Kleven2k/ramsey/rtl/ramsey_pkg.sv

package ramsey_pkg;

    // ---- Clock ---------------------------------------------
    localparam int CLK_FREQ_HZ = 100_000_000;  // Nexys Video Artix-7, 100 MHz

    // ---- UART ----------------------------------------------
    localparam int UART_BAUD   = 115_200;

endpackage
