Kleven2k/ramsey/python/gui.py

import ctypes
import dearpygui.dearpygui as dpg
import uart_comm
import lorentzian_fit
import synthetic

def main():
    dpg.create_context()
    dpg.create_viewport(title="Ramsey", width=1000, height=720)

    # ── Font ──────────────────────────────────────────────────────────────────
    with dpg.font_registry():
        default_font = dpg.add_font("C:/Windows/Fonts/segoeui.ttf", 16)

    # ── Global theme ──────────────────────────────────────────────────────────
    with dpg.theme(tag="global_theme"):
        with dpg.theme_component(dpg.mvAll):
            dpg.add_theme_style(dpg.mvStyleVar_WindowPadding,    10, 10)
            dpg.add_theme_style(dpg.mvStyleVar_FramePadding,      6,  4)
            dpg.add_theme_style(dpg.mvStyleVar_ItemSpacing,        8,  6)
            dpg.add_theme_style(dpg.mvStyleVar_FrameRounding,     4)
            dpg.add_theme_style(dpg.mvStyleVar_GrabRounding,      4)
            dpg.add_theme_style(dpg.mvStyleVar_WindowRounding,    4)
            dpg.add_theme_color(dpg.mvThemeCol_FrameBg,          (45, 45, 48))
            dpg.add_theme_color(dpg.mvThemeCol_FrameBgHovered,   (60, 60, 65))

    # ── Button themes ─────────────────────────────────────────────────────────
    with dpg.theme(tag="btn_red"):
        with dpg.theme_component(dpg.mvButton):
            dpg.add_theme_color(dpg.mvThemeCol_Button,        (160, 35,  35))
            dpg.add_theme_color(dpg.mvThemeCol_ButtonHovered, (200, 55,  55))
            dpg.add_theme_color(dpg.mvThemeCol_ButtonActive,  (120, 20,  20))
            dpg.add_theme_style(dpg.mvStyleVar_FrameRounding, 4)

    with dpg.theme(tag="btn_green"):
        with dpg.theme_component(dpg.mvButton):
            dpg.add_theme_color(dpg.mvThemeCol_Button,        (35,  140, 35))
            dpg.add_theme_color(dpg.mvThemeCol_ButtonHovered, (55,  175, 55))
            dpg.add_theme_color(dpg.mvThemeCol_ButtonActive,  (20,  110, 20))
            dpg.add_theme_style(dpg.mvStyleVar_FrameRounding, 4)

    with dpg.theme(tag="fit_series_theme"):
        with dpg.theme_component(dpg.mvLineSeries):
            dpg.add_theme_color(dpg.mvPlotCol_Line, (255, 160, 30),
                                category=dpg.mvThemeCat_Plots)
            dpg.add_theme_style(dpg.mvPlotStyleVar_LineWeight, 2.5,
                                category=dpg.mvThemeCat_Plots)

    with dpg.theme(tag="contrast_series_theme"):
        with dpg.theme_component(dpg.mvLineSeries):
            dpg.add_theme_color(dpg.mvPlotCol_Line, (100, 180, 255),
                                category=dpg.mvThemeCat_Plots)
            dpg.add_theme_style(dpg.mvPlotStyleVar_LineWeight, 1.2,
                                category=dpg.mvThemeCat_Plots)

    with dpg.theme(tag="btn_accent"):
        with dpg.theme_component(dpg.mvButton):
            dpg.add_theme_color(dpg.mvThemeCol_Button,        (0,   100, 180))
            dpg.add_theme_color(dpg.mvThemeCol_ButtonHovered, (0,   130, 210))
            dpg.add_theme_color(dpg.mvThemeCol_ButtonActive,  (0,    80, 150))
            dpg.add_theme_style(dpg.mvStyleVar_FrameRounding, 4)

    # ── State shared between callbacks ────────────────────────────────────────
    # Populated in on_config, read in on_packet to label the x-axis correctly.
    last_freqs_mhz   = []   # original (non-interleaved) sweep frequencies
    last_lock_in_en  = [False]  # wrapped in list so nonlocal assignment isn't needed
    last_bfield_demo = [False]  # suppress single Lorentzian fit in B-field demo mode
    continuous       = [False]  # continuous sweep mode

    sweep_history  = []   # list of contrast arrays, newest last
    MAX_SWEEPS     = 60

    last_sweep = {"freqs": [], "sig": [], "ref": [], "contrast": []}  # for CSV export

    # ── Callbacks ─────────────────────────────────────────────────────────────
    def set_status(msg):
        dpg.set_value("status_text", msg if len(msg) < 90 else msg[:87] + "...")

    def refresh_ports():
        ports = uart_comm.list_ports()
        dpg.configure_item("port_combo", items=ports)
        if ports:
            dpg.set_value("port_combo", ports[0])

    def on_connect():
        if uart_comm.is_connected():
            uart_comm.disconnect()
            continuous[0] = False
            dpg.configure_item("start_btn", label="START")
            set_status("Disconnected")
            dpg.configure_item("connect_btn", label="Connect")
            dpg.bind_item_theme("connect_btn", "btn_red")
        else:
            port = dpg.get_value("port_combo")
            try:
                uart_comm.connect(port)
                set_status(f"Connected on {port}")
                dpg.configure_item("connect_btn", label="Disconnect")
                dpg.bind_item_theme("connect_btn", "btn_green")
            except Exception as e:
                set_status(f"Error: {e}")

    def on_init():
        try:
            uart_comm.send_packet(uart_comm.MSG_INIT)
            set_status("Sent INIT")
        except ConnectionError as e:
            set_status(f"Error: {e}")

    def on_config():
        nonlocal last_freqs_mhz

        # Timing parameters (all in clock cycles; 1 cycle = 10 ns at 100 MHz)
        n_shots      = dpg.get_value("n_shots")
        init_dur     = dpg.get_value("init_dur")
        mw_dur       = dpg.get_value("mw_dur")
        dead_time    = dpg.get_value("dead_time")
        readout_dur  = dpg.get_value("readout_dur")
        ref_dur      = dpg.get_value("ref_dur")

        # Feedback parameters
        fb_enable    = 1 if dpg.get_value("fb_enable") else 0
        fb_threshold = dpg.get_value("fb_threshold")

        # Lock-in parameters
        lock_in_en  = 1 if dpg.get_value("lock_in_en") else 0
        delta_f_mhz = dpg.get_value("delta_f")
        delta_f_khz = int(round(delta_f_mhz * 1000))

        # Frequency sweep
        freq_start = dpg.get_value("freq_start")  # MHz
        freq_stop  = dpg.get_value("freq_stop")   # MHz
        freq_step  = dpg.get_value("freq_step")   # MHz

        # Build frequency list
        freqs_mhz = []
        f = freq_start
        while f <= freq_stop + 1e-9:
            freqs_mhz.append(round(f, 6))
            f += freq_step
        n_points = len(freqs_mhz)

        last_freqs_mhz.clear()
        last_freqs_mhz.extend(freqs_mhz)
        last_lock_in_en[0]  = bool(lock_in_en)
        last_bfield_demo[0] = False

        # Update x-axis to match new sweep range
        dpg.set_axis_limits("x_axis", freq_start, freq_stop)

        # ── Build freq table (interleaved if lock-in) ──────────────────────────
        if lock_in_en and delta_f_khz > 0:
            table_freqs_mhz = []
            for f_mhz in freqs_mhz:
                table_freqs_mhz.append(f_mhz + delta_f_mhz)
                table_freqs_mhz.append(f_mhz - delta_f_mhz)
        else:
            table_freqs_mhz = freqs_mhz
        n_points_table = len(table_freqs_mhz)

        # ── Build CONFIG payload ───────────────────────────────────────────────
        # Header (36 bytes):
        #   [0-1]   n_points_table uint16 big-endian  (2× n_points if lock-in)
        #   [2-5]   n_shots        uint32
        #   [6-9]   init_dur       uint32
        #   [10-13] mw_dur         uint32
        #   [14-17] readout_dur    uint32
        #   [18-21] ref_dur        uint32
        #   [22-25] dead_time      uint32
        #   [26]    lock_in_en     uint8
        #   [27-30] delta_f_khz    uint32
        #   [31]    fb_enable      uint8
        #   [32-35] fb_threshold   uint32
        # Followed by n_points_table × uint32 frequency values in kHz
        payload = []
        payload += list(n_points_table.to_bytes(2, 'big'))
        for val in [n_shots, init_dur, mw_dur, readout_dur, ref_dur, dead_time]:
            payload += list(int(val).to_bytes(4, 'big'))
        payload += [lock_in_en & 0x01]
        payload += list(delta_f_khz.to_bytes(4, 'big'))
        payload += [fb_enable & 0x01]
        payload += list(int(fb_threshold).to_bytes(4, 'big'))
        for f_mhz in table_freqs_mhz:
            f_khz = int(round(f_mhz * 1000))
            payload += list(f_khz.to_bytes(4, 'big'))

        mode_str = f"lock-in df={delta_f_mhz:.2f} MHz" if lock_in_en else "standard"
        try:
            uart_comm.send_packet(uart_comm.MSG_CONFIG, payload)
            set_status(f"Sent CONFIG - {n_points} pts {mode_str}, {freq_start:.1f}-{freq_stop:.1f} MHz")
        except ConnectionError as e:
            set_status(f"Error: {e}")

    def on_start():
        try:
            uart_comm.send_packet(uart_comm.MSG_START)
            set_status("Sent START - waiting for data...")
        except ConnectionError as e:
            set_status(f"Error: {e}")

    def on_demo():
        sweep_history.clear()
        freq_start  = dpg.get_value("freq_start")
        freq_stop   = dpg.get_value("freq_stop")
        freq_step   = dpg.get_value("freq_step")
        lock_in_en  = dpg.get_value("lock_in_en")
        delta_f_mhz = dpg.get_value("delta_f")
        f0_demo     = (freq_start + freq_stop) / 2
        gamma       = max((freq_stop - freq_start) / 20, freq_step * 3)

        # Build base frequency list
        freqs = []
        f = freq_start
        while f <= freq_stop + 1e-9:
            freqs.append(round(f, 6))
            f += freq_step

        last_freqs_mhz.clear()
        last_freqs_mhz.extend(freqs)
        last_lock_in_en[0]  = bool(lock_in_en)
        last_bfield_demo[0] = False
        dpg.set_axis_limits("x_axis", freq_start, freq_stop)

        if lock_in_en and delta_f_mhz > 0:
            # Build interleaved freq table [f+df, f-df, ...]
            interleaved = []
            for fq in freqs:
                interleaved.append(fq + delta_f_mhz)
                interleaved.append(fq - delta_f_mhz)
            payload = synthetic.generate_data_payload(
                interleaved, f0_mhz=f0_demo, contrast=0.05,
                gamma_mhz=gamma, ref_counts=500000,
            )
        else:
            payload = synthetic.generate_data_payload(
                freqs, f0_mhz=f0_demo, contrast=0.05,
                gamma_mhz=gamma, ref_counts=500000,
            )

        on_packet(uart_comm.MSG_DATA, list(payload))

    def on_demo_bfield():
        """Two-dip B-field demo. Auto-scales sweep window to always show both dips."""
        sweep_history.clear()
        b_mt       = dpg.get_value("demo_b_field")
        # If user drags slider manually, uncheck Earth's field preset
        if dpg.does_item_exist("demo_earth_field") and b_mt != 0.05:
            dpg.set_value("demo_earth_field", False)
            dpg.configure_item("demo_b_field", enabled=True)
        f0         = 2870.0
        gamma_e    = 28.0       # MHz/mT
        half_split = gamma_e * b_mt
        gamma_mhz  = 5.0        # fixed realistic linewidth

        # Window: always show both dips with 20 MHz margin each side
        margin     = max(20.0, half_split * 0.3)
        freq_start = round(f0 - half_split - margin, 1)
        freq_stop  = round(f0 + half_split + margin, 1)
        freq_step  = max(0.5, round((freq_stop - freq_start) / 200, 1))

        freqs = []
        f = freq_start
        while f <= freq_stop + 1e-9:
            freqs.append(round(f, 6))
            f += freq_step

        last_freqs_mhz.clear()
        last_freqs_mhz.extend(freqs)
        last_lock_in_en[0]  = False
        last_bfield_demo[0] = True
        dpg.set_axis_limits("x_axis", freq_start, freq_stop)

        payload = synthetic.generate_data_payload_split(
            freqs,
            f0_mhz     = f0,
            b_field_mt = b_mt,
            contrast   = 0.05,
            gamma_mhz  = gamma_mhz,
            ref_counts = 500000,
        )
        on_packet(uart_comm.MSG_DATA, list(payload))
        set_status(
            f"B-field demo: B={b_mt:.1f} mT  "
            f"f- = {f0 - half_split:.1f} MHz  "
            f"f+ = {f0 + half_split:.1f} MHz  "
            f"splitting = {2*half_split:.1f} MHz"
        )

    def on_earth_field_toggle():
        if dpg.get_value("demo_earth_field"):
            # Lock slider to Earth's field (50 µT = 0.05 mT)
            dpg.set_value("demo_b_field", 0.05)
            dpg.configure_item("demo_b_field", enabled=False)
        else:
            dpg.configure_item("demo_b_field", enabled=True)
        on_demo_bfield()

    def update_heatmap(freqs, contrast):
        n_freqs = len(freqs)
        if sweep_history and len(sweep_history[0]) != n_freqs:
            sweep_history.clear()
        sweep_history.append(list(contrast))
        if len(sweep_history) > MAX_SWEEPS:
            sweep_history.pop(0)
        n_sweeps = len(sweep_history)
        flat     = [float(v) for row in sweep_history for v in row]
        vmin     = min(flat)
        vmax     = max(flat)
        if vmin == vmax:
            vmax = vmin + 1e-6
        if dpg.does_item_exist("history_heatmap"):
            dpg.delete_item("history_heatmap")
        dpg.add_heat_series(flat, rows=n_sweeps, cols=n_freqs,
                            scale_min=vmin, scale_max=vmax,
                            bounds_min=(freqs[0],  0),
                            bounds_max=(freqs[-1], n_sweeps),
                            parent="hm_y_axis",
                            tag="history_heatmap",
                            format="")
        dpg.set_axis_limits("hm_x_axis", freqs[0], freqs[-1])
        dpg.set_axis_limits("hm_y_axis", 0,         n_sweeps)
        step = max(1, n_sweeps // 8)
        dpg.set_axis_ticks("hm_y_axis",
                           tuple((str(i), float(i))
                                 for i in range(0, n_sweeps + 1, step)))

    def on_export():
        import csv, datetime, os
        if not last_sweep["freqs"]:
            set_status("No data to export")
            return
        export_dir = os.path.join(os.path.dirname(__file__), "..", "data", "exports")
        os.makedirs(export_dir, exist_ok=True)
        ts = datetime.datetime.now().strftime("%Y%m%d_%H%M%S")
        path = os.path.join(export_dir, f"odmr_{ts}.csv")
        with open(path, "w", newline="") as f:
            w = csv.writer(f)
            w.writerow(["freq_mhz", "sig", "ref", "contrast"])
            for row in zip(last_sweep["freqs"], last_sweep["sig"],
                           last_sweep["ref"], last_sweep["contrast"]):
                w.writerow(row)
        set_status(f"Exported {len(last_sweep['freqs'])} pts → data/exports/{os.path.basename(path)}")

    def _update_count_display(avg_sig, avg_ref):
        n_shots  = max(dpg.get_value("n_shots"), 1)
        readout  = max(dpg.get_value("readout_dur"), 1)
        sig_shot = avg_sig / n_shots
        ref_shot = avg_ref / n_shots
        # count rate = counts per shot / readout window duration in seconds
        rate_hz  = sig_shot / (readout * 10e-9)
        if rate_hz >= 1e6:
            rate_str = f"{rate_hz/1e6:.2f} Mcps"
        elif rate_hz >= 1e3:
            rate_str = f"{rate_hz/1e3:.1f} kcps"
        else:
            rate_str = f"{rate_hz:.0f} cps"
        dpg.set_value("sig_per_shot", f"{sig_shot:.1f}")
        dpg.set_value("ref_per_shot", f"{ref_shot:.1f}")
        dpg.set_value("count_rate",   rate_str)

    def on_packet(msg_type, payload):
        if msg_type == uart_comm.MSG_ACK:
            set_status("ACK received")

        elif msg_type == uart_comm.MSG_DATA:
            # Each point is 8 bytes: 4 bytes sig (MSB first) + 4 bytes ref (MSB first)
            n_points_rx = len(payload) // 8
            if n_points_rx == 0:
                set_status("DATA received - empty payload")
                return

            sig_counts = []
            ref_counts = []
            for i in range(n_points_rx):
                base = i * 8
                sig = int.from_bytes(payload[base:base+4],   'big')
                ref = int.from_bytes(payload[base+4:base+8], 'big')
                sig_counts.append(sig)
                ref_counts.append(ref)

            # Contrast = (sig - ref) / ref  (negative dip = ODMR resonance)
            contrast = [
                (s - r) / r if r > 0 else 0.0
                for s, r in zip(sig_counts, ref_counts)
            ]

            if last_lock_in_en[0]:
                # ── Lock-in mode: demodulate interleaved pairs ─────────────────
                # Even indices = f+df, odd indices = f-df
                # error[i] = contrast[2i] - contrast[2i+1]  (derivative lineshape)
                n_pairs = n_points_rx // 2
                error = [
                    contrast[2*i] - contrast[2*i + 1]
                    for i in range(n_pairs)
                ]

                if len(last_freqs_mhz) >= n_pairs:
                    x_vals = last_freqs_mhz[:n_pairs]
                else:
                    x_vals = list(range(n_pairs))

                dpg.set_value("contrast_series", [x_vals, error])

                # Zero-crossing fit for f0
                result = lorentzian_fit.zero_crossing(x_vals, error)
                if result:
                    dpg.set_value("fit_series", [x_vals, result["fitted_y"]])
                    fit_info = f"lock-in | f0 = {result['f0']:.2f} MHz"
                else:
                    dpg.set_value("fit_series", [[], []])
                    fit_info = "lock-in | no zero crossing"

                e_min = min(error)
                e_max = max(error)
                margin = max(abs(e_max - e_min) * 0.1, 0.005)
                dpg.set_axis_limits("y_axis", e_min - margin, e_max + margin)
                set_status(f"{n_pairs} pairs | {fit_info}")
                update_heatmap(x_vals, error)
                avg_sig = sum(sig_counts) // max(len(sig_counts), 1)
                avg_ref = sum(ref_counts) // max(len(ref_counts), 1)
                _update_count_display(avg_sig, avg_ref)

            else:
                # ── Standard mode: Lorentzian fit ──────────────────────────────
                if len(last_freqs_mhz) >= n_points_rx:
                    x_vals = last_freqs_mhz[:n_points_rx]
                else:
                    x_vals = list(range(n_points_rx))

                dpg.set_value("contrast_series", [x_vals, contrast])

                if last_bfield_demo[0]:
                    result = lorentzian_fit.fit_split(x_vals, contrast)
                    if result:
                        dpg.set_value("fit_series", [x_vals, result["fitted_y"]])
                        fit_info = (
                            f"f- = {result['f_minus']:.1f} MHz  "
                            f"f+ = {result['f_plus']:.1f} MHz  "
                            f"splitting = {result['splitting']:.1f} MHz  "
                            f"B = {result['b_field_mt']:.2f} mT"
                        )
                    else:
                        dpg.set_value("fit_series", [[], []])
                        fit_info = f"{n_points_rx} pts | B-field demo | fit failed"
                else:
                    result = lorentzian_fit.fit(x_vals, contrast)
                    if result:
                        dpg.set_value("fit_series", [x_vals, result["fitted_y"]])
                        fit_info = (
                            f"f0 = {result['f0']:.2f} +/- {result['f0_err']:.2f} MHz  "
                            f"FWHM = {result['gamma']:.2f} MHz  "
                            f"A = {result['a']*100:.2f}%"
                        )
                    else:
                        dpg.set_value("fit_series", [[], []])
                        fit_info = "fit failed"

                c_min = min(contrast)
                c_max = max(contrast)
                margin = max(abs(c_max - c_min) * 0.1, 0.005)
                dpg.set_axis_limits("y_axis", c_min - margin, c_max + margin)
                avg_sig = sum(sig_counts) // max(len(sig_counts), 1)
                avg_ref = sum(ref_counts) // max(len(ref_counts), 1)
                set_status(f"{n_points_rx} pts | {fit_info} | sig={avg_sig} ref={avg_ref}")
                update_heatmap(x_vals, contrast)
                _update_count_display(avg_sig, avg_ref)
                last_sweep.update({"freqs": x_vals, "sig": sig_counts,
                                   "ref": ref_counts, "contrast": contrast})

        if continuous[0]:
            try:
                uart_comm.send_packet(uart_comm.MSG_START)
            except ConnectionError:
                continuous[0] = False
                dpg.configure_item("start_btn", label="START")

    uart_comm.set_packet_callback(on_packet)

    # ── Presets ───────────────────────────────────────────────────────────────
    PRESETS = {
        "NV - CW ODMR": {
            "n_shots": 1000, "init_dur": 5000, "mw_dur": 1000,
            "dead_time": 0,  "readout_dur": 300, "ref_dur": 300,
            "freq_start": 2800.0, "freq_stop": 2900.0, "freq_step": 1.0,
        },
        "NV - Pulsed ODMR": {
            "n_shots": 5000, "init_dur": 3000, "mw_dur": 100,
            "dead_time": 100, "readout_dur": 300, "ref_dur": 300,
            "freq_start": 2820.0, "freq_stop": 2920.0, "freq_step": 1.0,
        },
        "SiV - 1.38 GHz": {
            "n_shots": 1000, "init_dur": 5000, "mw_dur": 1000,
            "dead_time": 0,  "readout_dur": 300, "ref_dur": 300,
            "freq_start": 1330.0, "freq_stop": 1430.0, "freq_step": 1.0,
        },
        "Alignment (APD check)": {
            "n_shots": 10000, "init_dur": 500, "mw_dur": 0,
            "dead_time": 0,   "readout_dur": 300, "ref_dur": 300,
            "freq_start": 2870.0, "freq_stop": 2870.0, "freq_step": 1.0,
        },
    }

    def on_preset(sender, app_data):
        p = PRESETS.get(app_data)
        if not p:
            return
        for key, val in p.items():
            dpg.set_value(key, val)

    # ── UI ────────────────────────────────────────────────────────────────────
    with dpg.window(tag="Primary Window"):

        # ── Connection bar ────────────────────────────────────────────────────
        with dpg.group(horizontal=True):
            dpg.add_text("Port:")
            dpg.add_combo(uart_comm.list_ports(), tag="port_combo", width=90)
            dpg.add_button(label="R", callback=refresh_ports, width=26)
            dpg.add_button(label="Connect", tag="connect_btn",
                           callback=on_connect, width=100)
            dpg.add_text("|")
            dpg.add_text("--", tag="status_text")

        dpg.add_separator()

        # ── Main split ───────────────────────────────────────────────────────
        with dpg.group(horizontal=True):

            # ── Control panel ─────────────────────────────────────────────────
            with dpg.child_window(width=230, height=-1, border=False):

                dpg.add_text("PRESET", color=(150, 150, 150))
                dpg.add_separator()
                dpg.add_combo(list(PRESETS.keys()), tag="preset_combo",
                              width=-1, callback=on_preset,
                              default_value="NV - CW ODMR")
                dpg.add_spacer(height=6)
                dpg.add_text("TIMING  (clock cycles)", color=(150, 150, 150))
                dpg.add_separator()
                dpg.add_input_int(label="n_shots",       tag="n_shots",
                                  default_value=1000,    width=120)
                dpg.add_input_int(label="init",          tag="init_dur",
                                  default_value=500,     width=120)
                dpg.add_input_int(label="MW",            tag="mw_dur",
                                  default_value=100,     width=120)
                dpg.add_input_int(label="dead",          tag="dead_time",
                                  default_value=0,       width=120)
                dpg.add_input_int(label="readout",       tag="readout_dur",
                                  default_value=300,     width=120)
                dpg.add_input_int(label="ref",           tag="ref_dur",
                                  default_value=300,     width=120)

                dpg.add_spacer(height=6)
                dpg.add_text("FREQUENCY  (MHz)", color=(150, 150, 150))
                dpg.add_separator()
                dpg.add_input_float(label="start", tag="freq_start",
                                    default_value=1300.0, width=120, format="%.1f")
                dpg.add_input_float(label="stop",  tag="freq_stop",
                                    default_value=1400.0, width=120, format="%.1f")
                dpg.add_input_float(label="step",  tag="freq_step",
                                    default_value=1.0,    width=120, format="%.2f")

                dpg.add_spacer(height=6)
                dpg.add_text("LOCK-IN  (FSK mode)", color=(150, 150, 150))
                dpg.add_separator()
                dpg.add_checkbox(label="enable", tag="lock_in_en",
                                 default_value=False)
                dpg.add_input_float(label="df (MHz)", tag="delta_f",
                                    default_value=0.5, width=120, format="%.2f")

                dpg.add_spacer(height=6)
                dpg.add_text("FEEDBACK  (active reset)", color=(150, 150, 150))
                dpg.add_separator()
                dpg.add_checkbox(label="enable", tag="fb_enable",
                                 default_value=False)
                dpg.add_input_int(label="threshold", tag="fb_threshold",
                                  default_value=0, width=120)

                dpg.add_spacer(height=10)
                dpg.add_separator()
                dpg.add_spacer(height=4)
                dpg.add_button(label="INIT",   callback=on_init,   width=-1)
                dpg.add_spacer(height=2)
                dpg.add_button(label="CONFIG", callback=on_config, width=-1)
                dpg.add_spacer(height=2)
                dpg.add_button(label="START",  callback=on_start,  width=-1,
                               tag="start_btn")
                dpg.add_spacer(height=2)
                dpg.add_button(label="DEMO",   callback=on_demo,   width=-1,
                               tag="demo_btn")
                dpg.add_spacer(height=6)
                dpg.add_text("DEMO  B-field", color=(150, 150, 150))
                dpg.add_separator()
                dpg.add_checkbox(label="Earth's field (50 uT)", tag="demo_earth_field",
                                 default_value=False, callback=on_earth_field_toggle)
                dpg.add_slider_float(label="B (mT)", tag="demo_b_field",
                                     default_value=1.0, min_value=0.0, max_value=5.0,
                                     width=-1, format="%.2f mT",
                                     callback=on_demo_bfield)
                dpg.add_button(label="DEMO (B-field)", callback=on_demo_bfield, width=-1,
                               tag="demo_bfield_btn")
                dpg.add_spacer(height=2)
                dpg.add_button(label="EXPORT CSV", callback=on_export, width=-1)

            dpg.add_spacer(width=4)

            # ── Plot panel ────────────────────────────────────────────────────
            with dpg.child_window(width=-1, height=-1, border=False):
              with dpg.group(horizontal=True):

                # ── Plots ────────────────────────────────────────────────────
                with dpg.group():
                  with dpg.plot(label="ODMR Spectrum", height=370, width=-130,
                              tag="odmr_plot"):
                    dpg.add_plot_legend()
                    dpg.add_plot_axis(dpg.mvXAxis,
                                      label="Frequency (MHz)",
                                      tag="x_axis")
                    dpg.add_plot_axis(dpg.mvYAxis,
                                      label="Contrast  (dPL/PL)",
                                      tag="y_axis")
                    dpg.add_line_series([], [], label="Contrast",
                                        parent="y_axis",
                                        tag="contrast_series")
                    dpg.add_line_series([], [], label="Fit",
                                        parent="y_axis",
                                        tag="fit_series")
                    dpg.set_axis_limits("x_axis", 1300, 1400)
                    dpg.set_axis_limits("y_axis", -0.1, 0.1)

                  dpg.add_spacer(height=4)

                  with dpg.plot(label="Sweep History", height=-1, width=-130,
                                tag="history_plot", no_mouse_pos=True):
                    dpg.add_plot_axis(dpg.mvXAxis,
                                      label="Frequency (MHz)",
                                      tag="hm_x_axis", no_gridlines=True)
                    dpg.add_plot_axis(dpg.mvYAxis,
                                      label="Sweep #",
                                      tag="hm_y_axis", no_gridlines=True)
                    dpg.add_heat_series([0.0], rows=1, cols=1,
                                        scale_min=-0.1, scale_max=0.0,
                                        bounds_min=(1300, 0),
                                        bounds_max=(1400, 1),
                                        parent="hm_y_axis",
                                        tag="history_heatmap",
                                        format="")
                    dpg.set_axis_limits("hm_x_axis", 1300, 1400)
                    dpg.set_axis_limits("hm_y_axis", 0, 1)

                # ── Count stats panel ────────────────────────────────────────
                with dpg.child_window(width=120, height=-1, border=False):
                    dpg.add_spacer(height=20)
                    dpg.add_text("COUNTS", color=(150, 150, 150))
                    dpg.add_separator()
                    dpg.add_spacer(height=8)
                    dpg.add_text("sig/shot", color=(100, 180, 255))
                    dpg.add_text("—", tag="sig_per_shot")
                    dpg.add_spacer(height=8)
                    dpg.add_text("ref/shot", color=(180, 180, 180))
                    dpg.add_text("—", tag="ref_per_shot")
                    dpg.add_spacer(height=8)
                    dpg.add_text("rate", color=(100, 220, 100))
                    dpg.add_text("—", tag="count_rate")
              dpg.bind_colormap("history_plot", dpg.mvPlotColormap_Plasma)

    # ── Apply themes and font ─────────────────────────────────────────────────
    dpg.bind_font(default_font)
    dpg.bind_theme("global_theme")
    dpg.bind_item_theme("connect_btn",      "btn_red")
    dpg.bind_item_theme("start_btn",        "btn_accent")
    dpg.bind_item_theme("demo_btn",         "btn_accent")
    dpg.bind_item_theme("demo_bfield_btn", "btn_accent")
    dpg.bind_item_theme("contrast_series",  "contrast_series_theme")
    dpg.bind_item_theme("fit_series",       "fit_series_theme")

    def on_resize():
        vh       = dpg.get_viewport_height()
        chrome   = 68  # connection bar + separator + window padding
        available = max(400, vh - chrome)
        dpg.configure_item("odmr_plot",    height=int(available * 0.60))
        dpg.configure_item("history_plot", height=int(available * 0.38))

    dpg.set_viewport_resize_callback(on_resize)

    dpg.setup_dearpygui()
    dpg.show_viewport()

    # Centre the viewport on the screen
    user32 = ctypes.windll.user32
    sw = user32.GetSystemMetrics(0)
    sh = user32.GetSystemMetrics(1)
    vw = dpg.get_viewport_width()
    vh = dpg.get_viewport_height()
    dpg.set_viewport_pos([(sw - vw) // 2, (sh - vh) // 2])

    dpg.set_primary_window("Primary Window", True)
    on_resize()
    dpg.start_dearpygui()
    dpg.destroy_context()

if __name__ == "__main__":
    main()
