Kleven2k/ramsey/(commit log)

2026-04-13 Initial commit — Ramsey ODMR pulse sequencer
    Full stack: RTL pulse sequencer + photon counter (Artix-7), ADF4351
    SPI driver, UART protocol, Python GUI with Lorentzian fit, cocotb
    testbenches for all modules, physics notebook, and characterization
    infrastructure.
2026-04-14 Remove plan and sensor expo from tracking
2026-04-18 Modified plot resizing issue
    [gui.py]
2026-04-21 Fix three bugs found during ADF4351 bench test
    - uart_interface: remove premature tx_payload_req in TX_LEN_LO, caused
    1-byte shift in every DATA payload
    - shot_accumulator: remove for-loop always_ff init block, created multiple
    drivers for sig_mem/ref_mem — Vivado discarded write-back silently
    - uart_comm: reader thread no longer dies on SerialTimeoutException between sweeps
    - ramsey_top: tie lock_detect high as temporary bypass (ADF4351 LD = 0V)
    [gui.py, ramsey_top.sv, shot_accumulator.sv, uart_comm.py, uart_interface.sv]
2026-04-26 Fixed bug, ADF4351 will now lock
    [freq_calc.sv, ramsey_top.sv]
2026-04-26 Updated GUI will now correctly be able to sweep different values, madde top and freq_calc module compatible with NV sensor
    [freq_calc.sv, gui.py, ramsey_top.sv]
2026-04-26 Updated pin connections
2026-04-27 Added C E pin connection
2026-04-27 fix(sim): clear accumulator BRAM on rst/sweep_start; update freq_calc tests for GCD-reduced MOD
    [freq_calc_tb_wrapper.sv, shot_accumulator.sv, test_freq_calc.py, test_integration.py, test_shot_accumulator.py]
2026-04-27 feat(gui): continuous sweep, photon count display, CSV export, NV presets, lock-in demo fix
    [gui.py, ramsey_top.sv]
2026-04-28 fix: tried continuous sweep (failed); lock detect bypass
    [gui.py, ramsey_top.sv]
2026-09-01 fix: update top-level RTL, XDC constraints, build script, and logo assets
    [nexys_video.xdc, ramsey_top.sv]
2026-09-01 fix(sim): add missing clock cycle in cocotb v2 timing for feedback testbenches
    [test_feedback.py]
